Rijenkii/guitar-hero-adapter/(commit log)

2019-01-28 Update README
    Apparently 3.3V Pro Micros exist
2019-01-31 Add comments, rename project file
    Because apparently Arduino IDE doesn't like when project name and folder name are different
    [arduino-wiitar-adapter.ino]
2019-01-31 Add a warning that 168/328 boards won't work
